xn--nding-jua/UltranetReceiver/ConnectionP16I.jpg

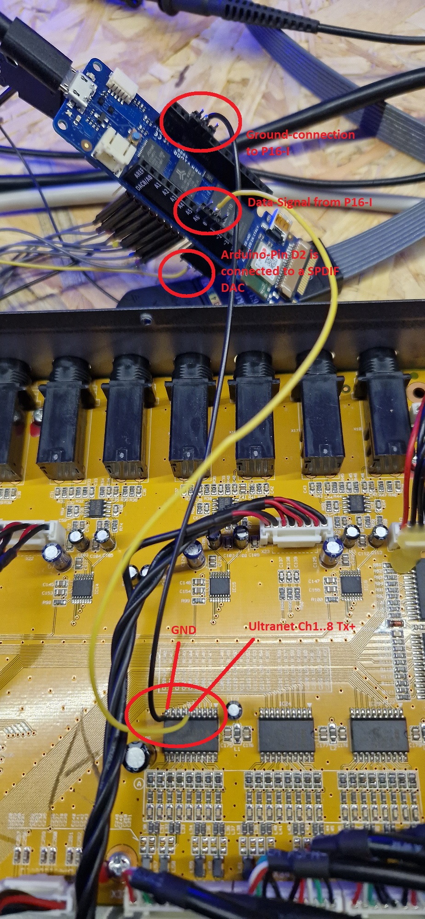
ConnectionP16I.jpg
