xn--nding-jua/UltranetReceiver/UltranetReceiver (FPGA).png

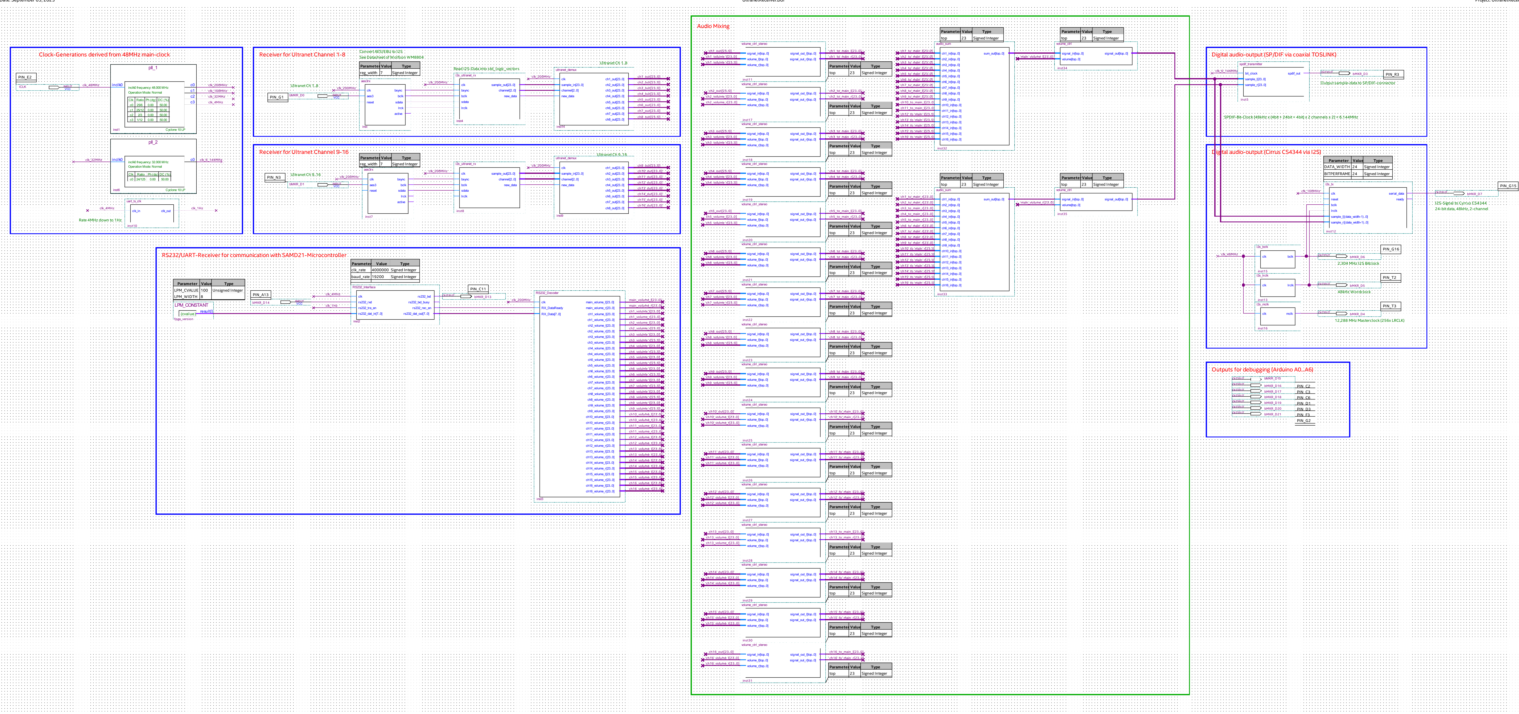
UltranetReceiver (FPGA).png
