xn--nding-jua/UltranetReceiver/PCB/FPGA_AudioMischpult.pdf

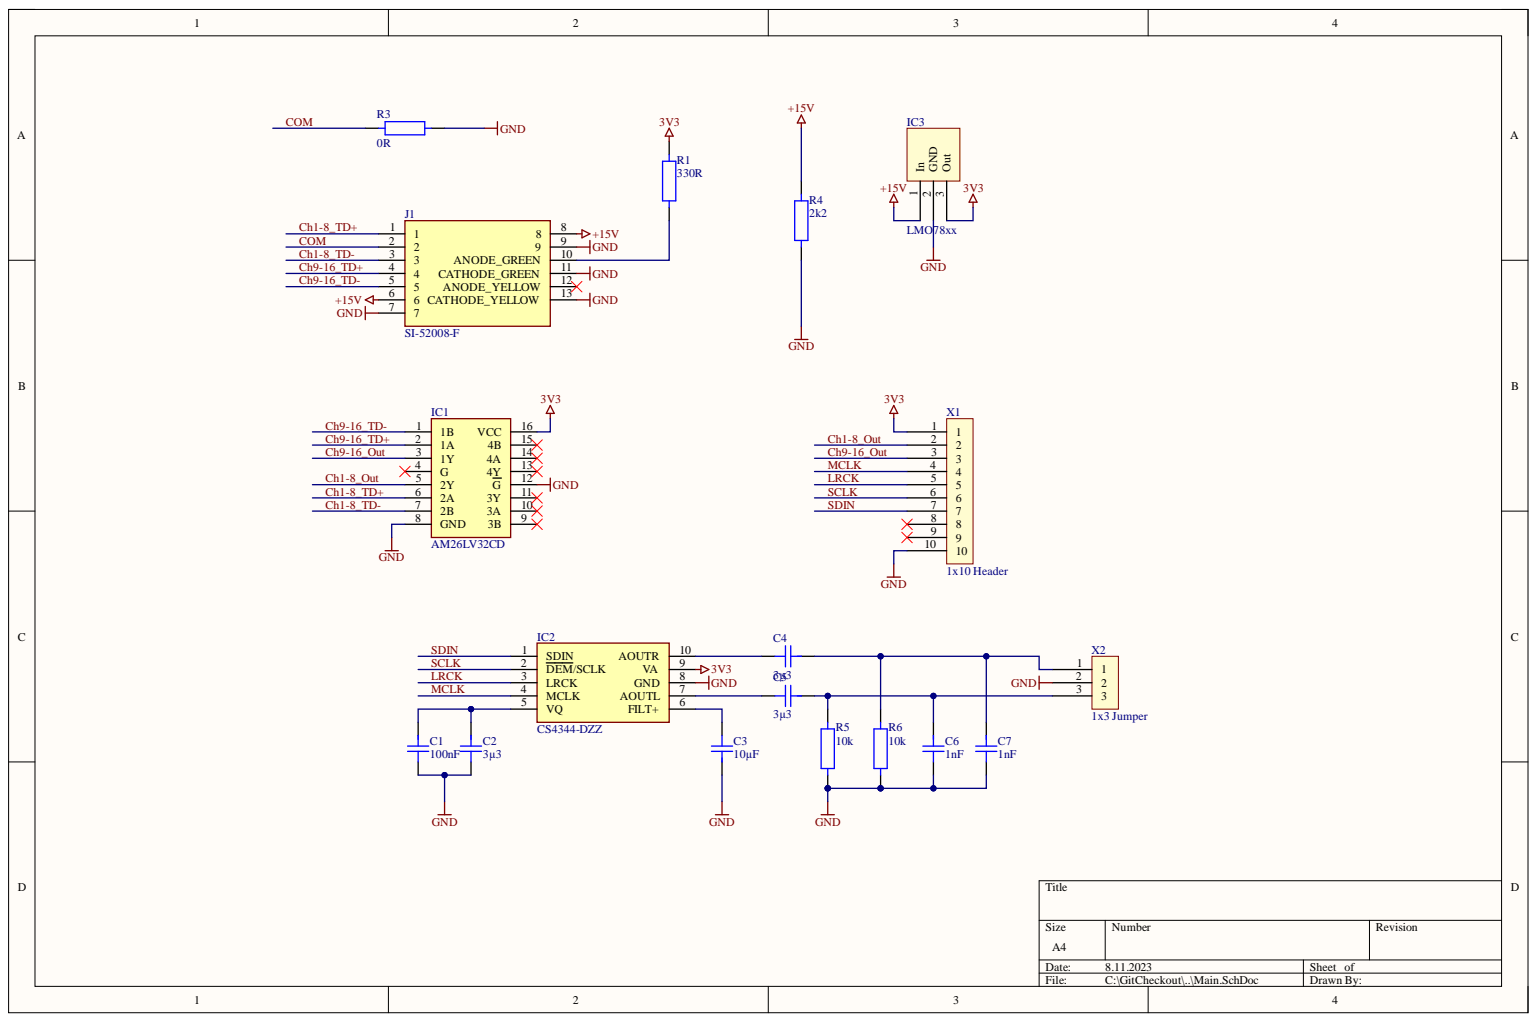
[picture p5: page 1]

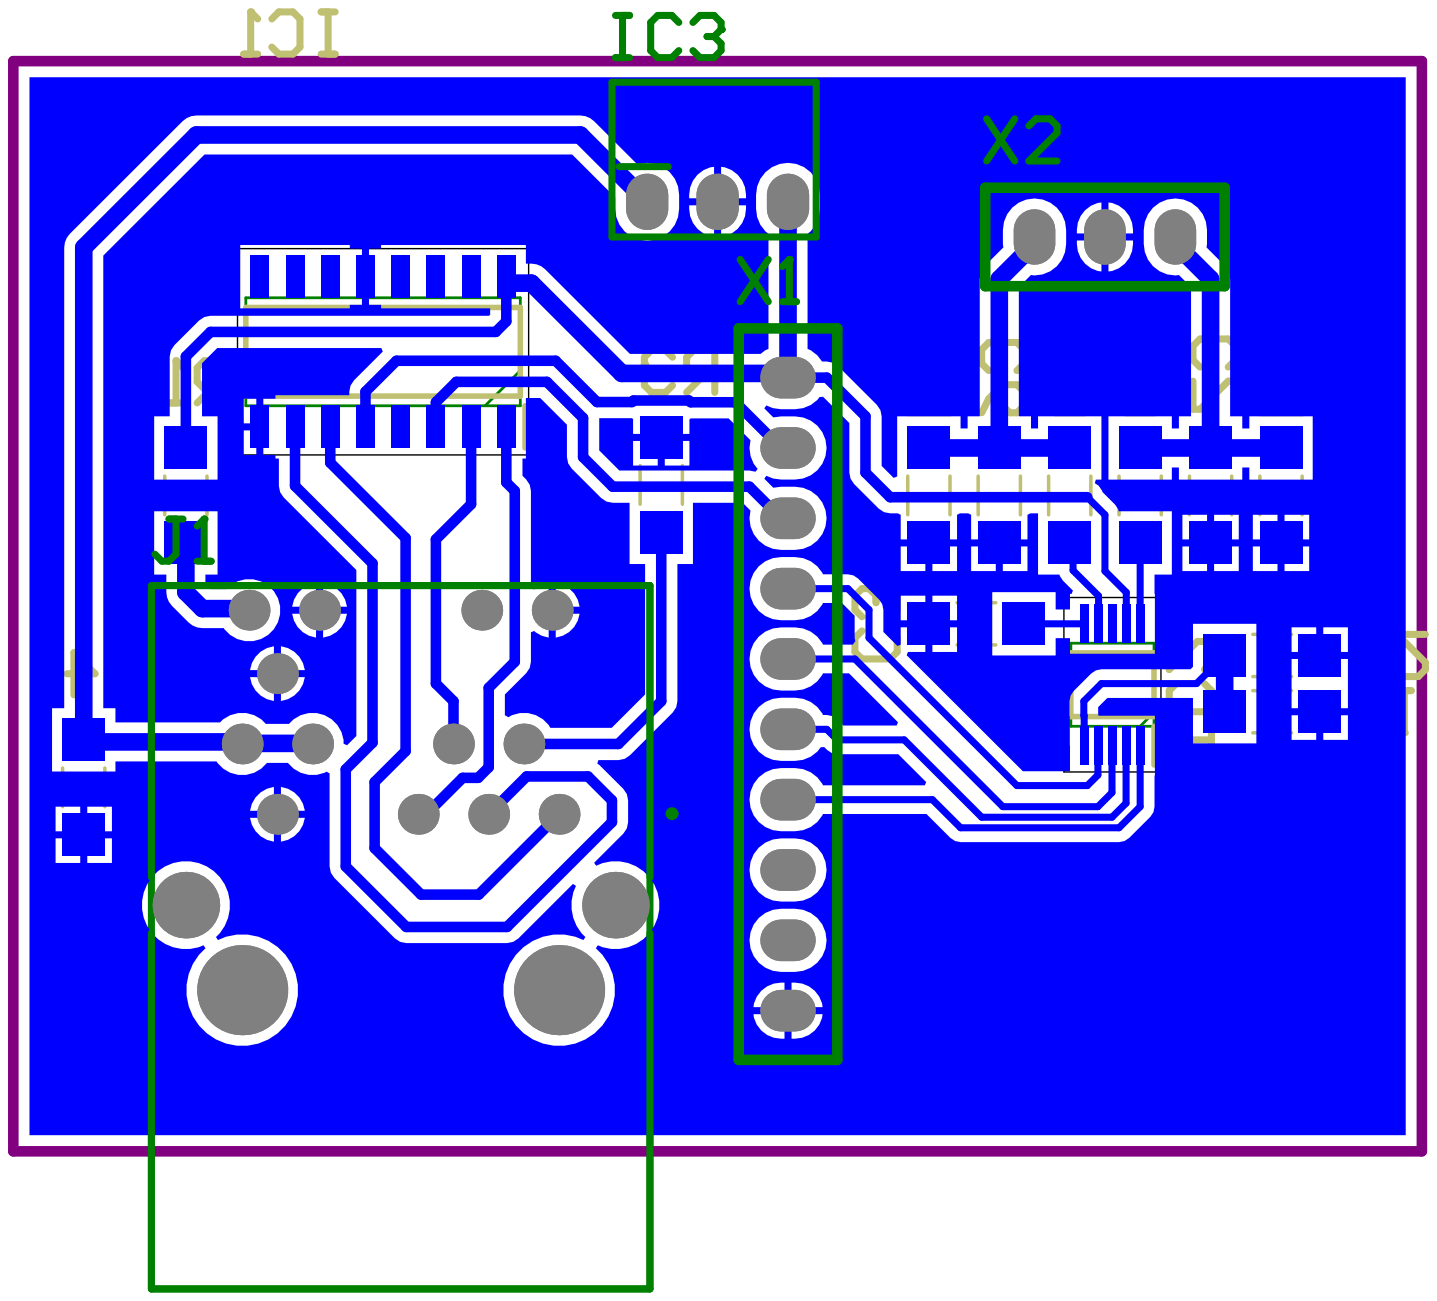
[picture p6: page 2]
