xn--nding-jua/UltranetReceiver/(list of files, drawings)

Other design files:
PCB/FPGA_AudioMischpult.PrjPcb
PCB/Main.SchDoc
PCB/PCB.PcbDoc
