xn--nding-jua/UltranetReceiver/Controller/HelperFunctions.ino

#if UseEthernet == 1
String IpAddress2String(const IPAddress& address){
  return String(address[0]) + "." + address[1] + "." + address[2] + "." + address[3];
}

String mac2String(byte ar[]) {
  String s;
  for (byte i = 0; i < 6; ++i)
  {
    char buf[3];
    sprintf(buf, "%02X", ar[i]); // J-M-L: slight modification, added the 0 in the format for padding 
    s += buf;
    if (i < 5) s += ':';
  }
  return s;
}
#endif

String split(String s, char parser, int index) {
  String rs="";
  int parserIndex = index;
  int parserCnt=0;
  int rFromIndex=0, rToIndex=-1;
  while (index >= parserCnt) {
    rFromIndex = rToIndex+1;
    rToIndex = s.indexOf(parser,rFromIndex);
    if (index == parserCnt) {
      if (rToIndex == 0 || rToIndex == -1) return "";
      return s.substring(rFromIndex,rToIndex);
    } else parserCnt++;
  }
  return rs;
}
