xn--nding-jua/UltranetReceiver/FPGA/i2s_bclk.vhd

-- create LRCLK from BCLK for I2S

LIBRARY IEEE;    
USE IEEE.STD_LOGIC_1164.ALL;    

entity i2s_bclk is
    port (
        clk		: in std_logic;
        bclk	: out std_logic
    );
end i2s_bclk;

architecture Behavioral of i2s_bclk is
    signal count : integer := 0;
    signal b : std_logic := '0';
begin
    process(clk)     
    begin
        if(rising_edge(clk)) then
            count <=count+1; -- incrementing every rising edge
            if(count = 20832) then
                b <= not b;
                count <=0;
            end if;
        end if;
    end process;

	 bclk<=b;
end;
