xn--nding-jua/UltranetReceiver/(commit log)

2023-08-11 Add schematics and PCB
    [FPGA_AudioMischpult.PrjPcb, Main.SchDoc, PCB.PcbDoc]
2023-08-11 Fixed wrong connections to buffer
    [FPGA_AudioMischpult.PrjPcb, Main.SchDoc, PCB.PcbDoc]
2023-09-02 Several minor cleanups in code. Increased clock to 200MHz. Added second PLL for clock-generation of 6.144MHz for SPDIF. Code tested with P16-I connected to Arduino MKR Vidor 4000 directly.
2023-09-02 Added UART-receiver. Added I2S-interface for Cyrrus CS4344. Changed processing in ultranet_demux.vhdl to clock-based.
2023-09-02 Added missing headers and copyright-infos to some files
    [RS232_Decoder.vhdl, i2s_tx.vhd, i2s_ultranet_rx.vhd, ultranet_demux.vhd]
2023-09-03 Add ErrorCheckWord to communication between FPGA and microcontroller. Implemented general volume-control.
    [Communication.ino, RS232_Decoder.vhdl]
2024-05-28 Fixed a bug on decoding ultranet with wrong audio-level
    [i2s_ultranet_rx.vhd]
2024-05-28 Updated FPGA-project for Quartus 23. Replaced PDM-modulator with better one. Compiled and updated bitstream.h of controller.
    [dac_pdm.vhd]
